usevolt/ccu/ce_mark_ccu.pdf

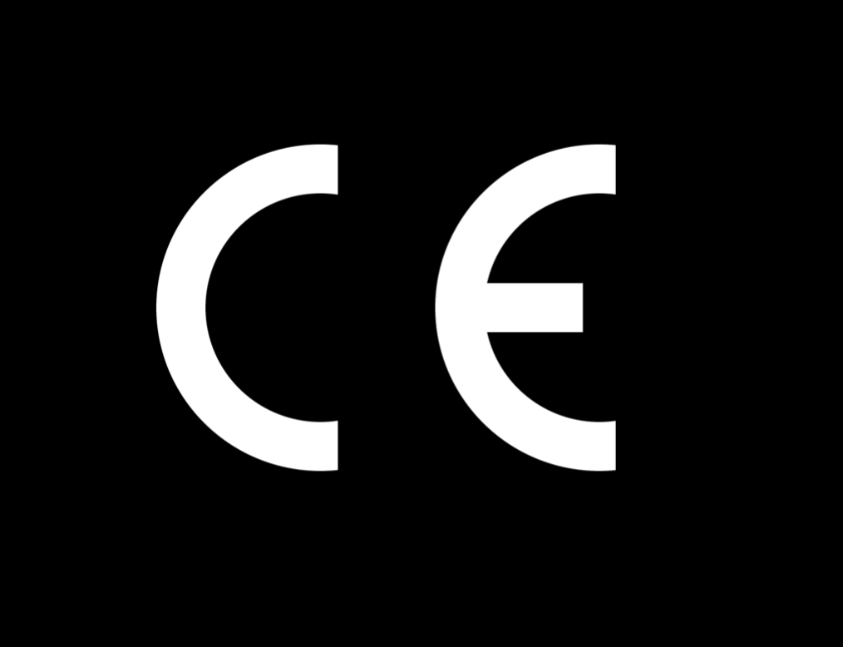
[picture p1: figure]

www.usewood.fi

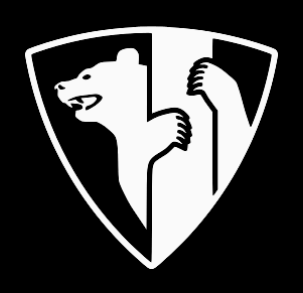
[picture p2: figure]

# Usewood CCU
