usevolt/ccu/ce_mark_ccu_55x20mm.png

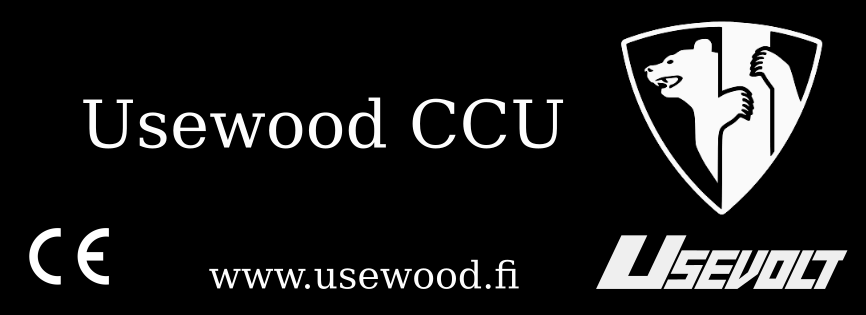
ce_mark_ccu_55x20mm.png
