usevolt/ccu/hw/ccu.FCStd

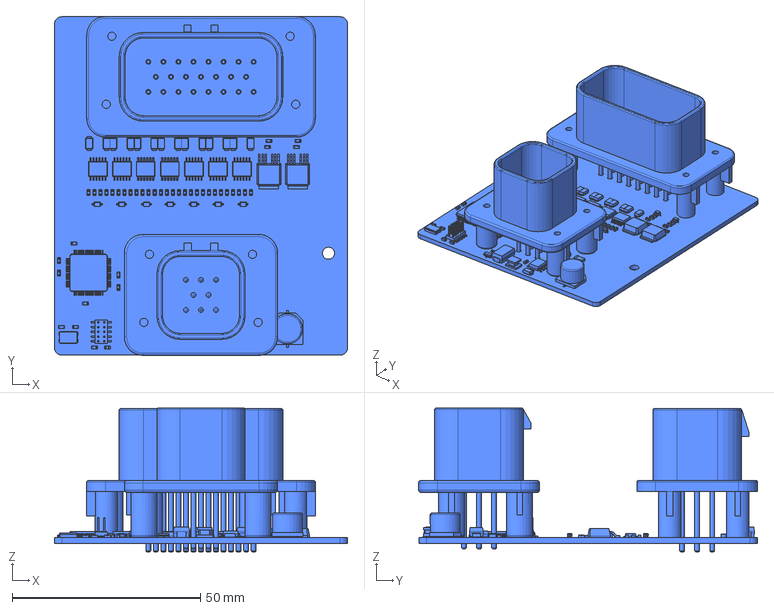
[picture p4: CAD file, 2018-11-13]
hw/ccu.FCStd
78.0 x 90.2 x 38.2 mm
