usevolt/ccu/hw/ccu_heatsink.step

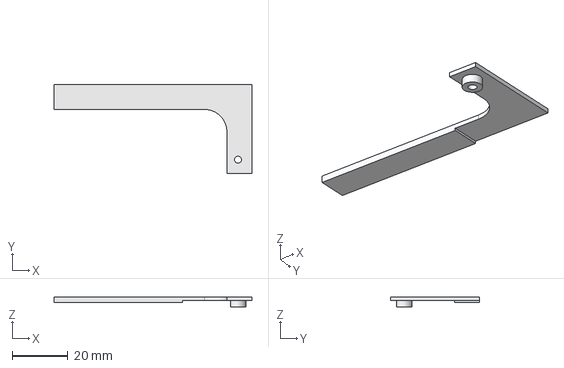
[picture p5: CAD file, 2018-11-07]
hw/ccu_heatsink.step
71.0 x 32.0 x 3.70 mm
