usevolt/ccu/hw/board_outline.dxf

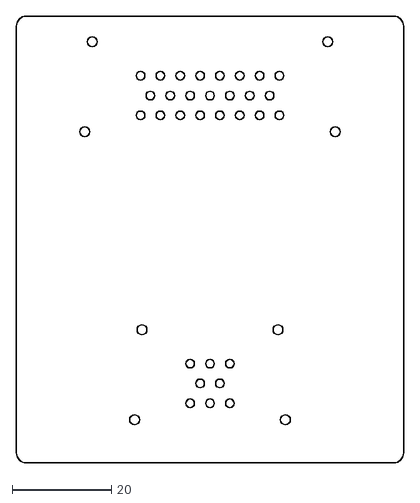
[picture p6: CAD file, 2018-07-01]
hw/board_outline.dxf
78.0 x 90.0
