usevolt/ccu/(list of files, cad)

Other CAD files:
hw/ccu_heatsink.fcstd
