usevolt/ccu/hw/ccu_heatsink.pdf

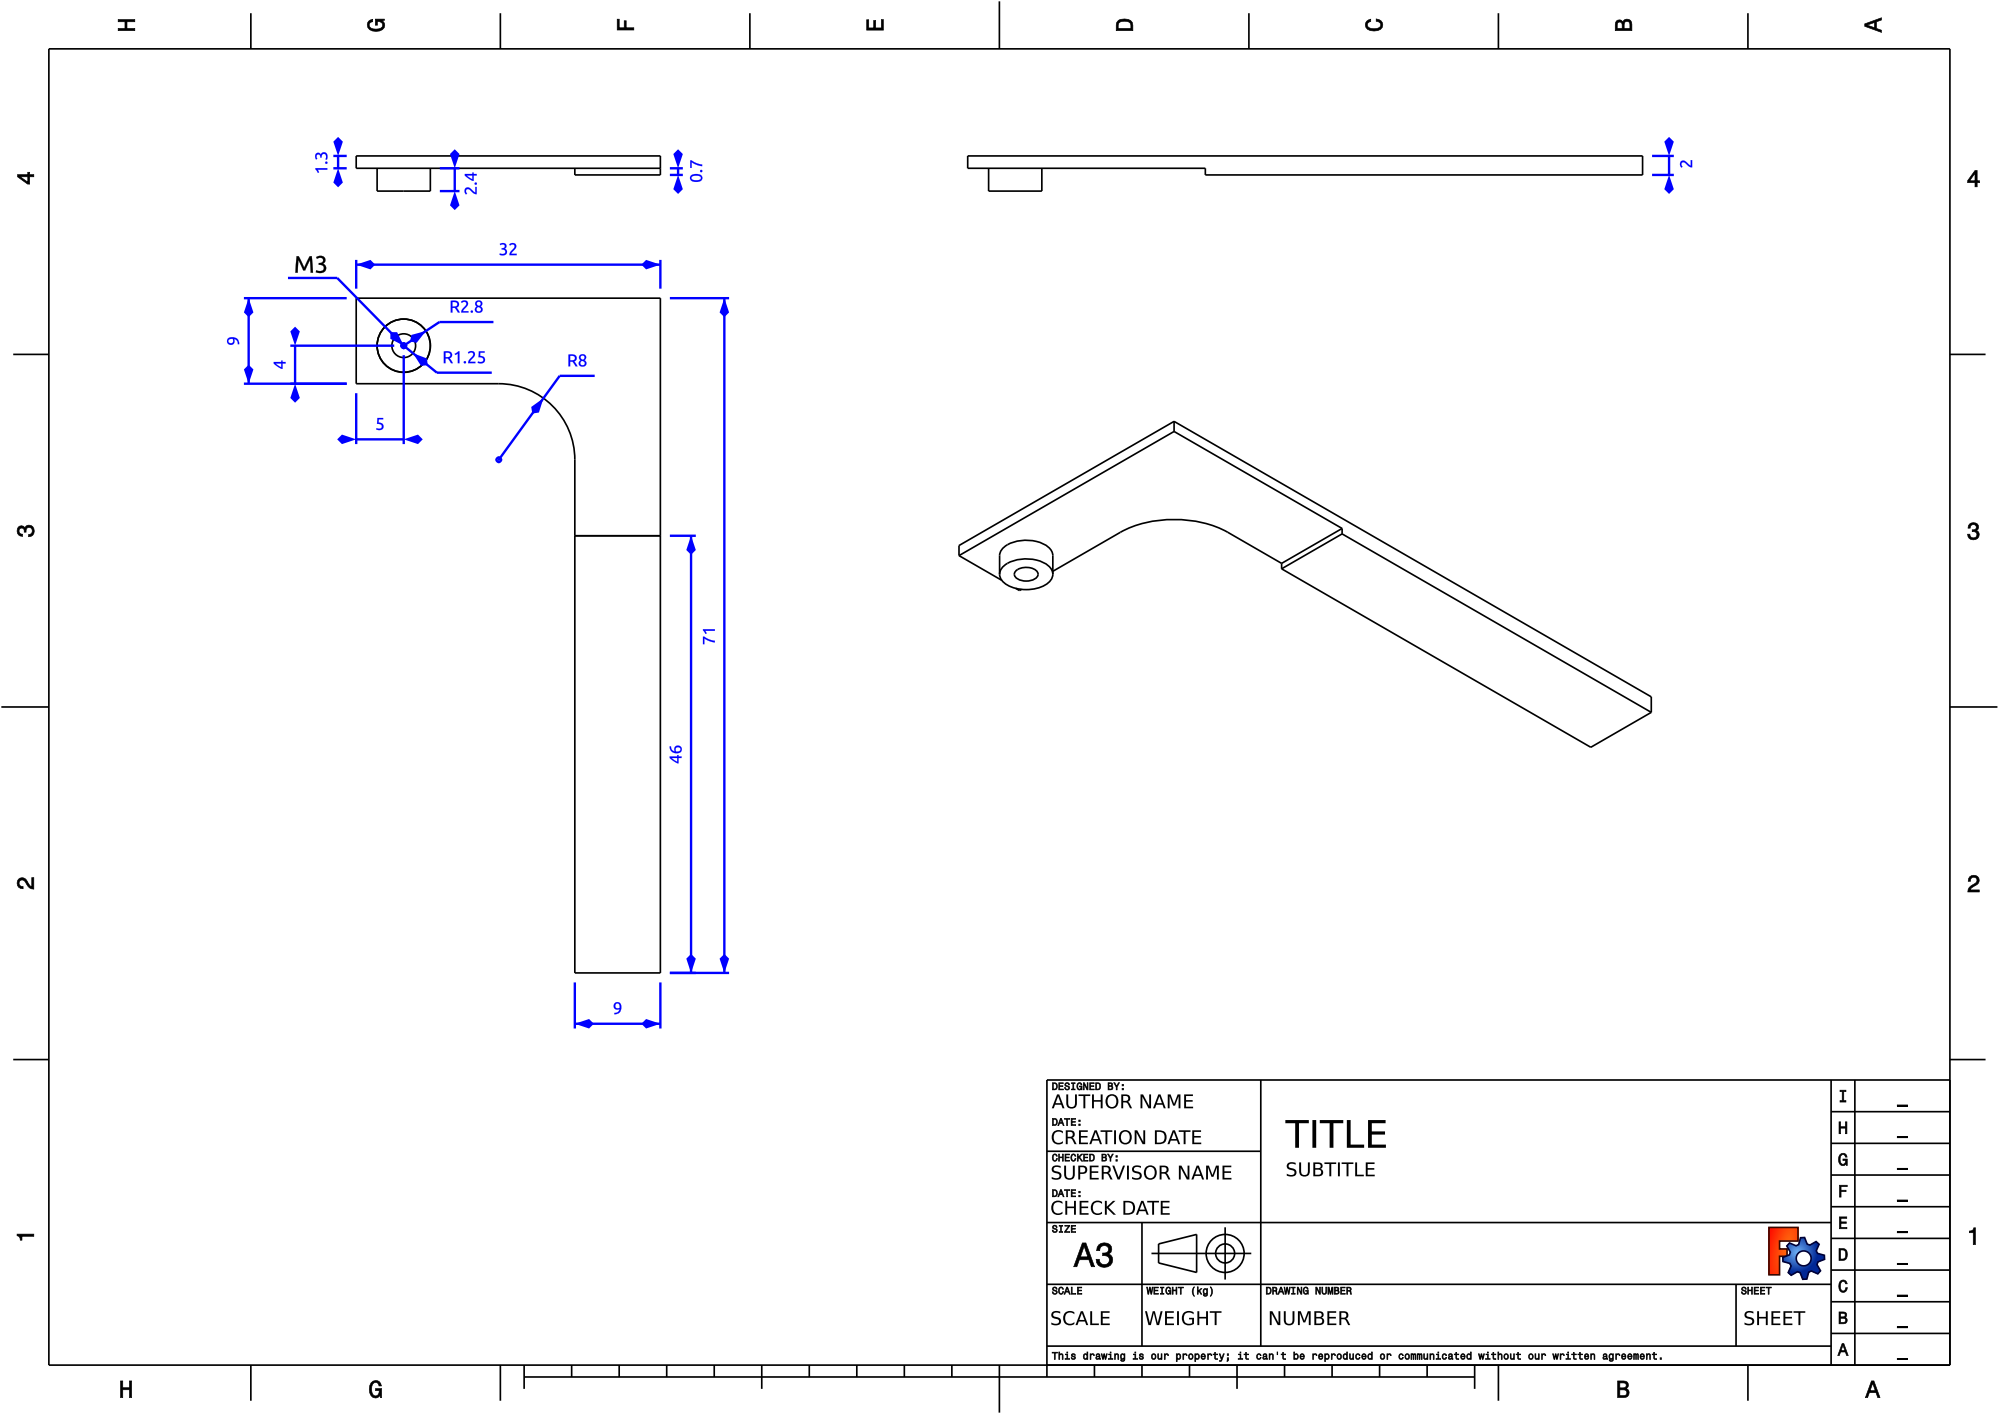
[picture p7: page 1]
