usevolt/ccu/sw/inc/pin_mappings.h

/*
 * pin_mappings.h
 *
 *  Created on: Jan 27, 2015
 *      Author: usenius
 *
 *  Defines keypad pin mappings for different pcb revisions used
 */

#ifndef UW_MB_SRC_PIN_MAPPINGS_H_
#define UW_MB_SRC_PIN_MAPPINGS_H_


#define PCB_1_5
//#define PCB_1_4

#if defined(PCB_1_5)
#define MCP2515_RESET		P0_17
#define SPI_CS_IO			P1_7
#define SPI_CLK_IO			P1_8
#elif defined(PCB_1_4)
#define MCP2515_RESET		P1_1
#define SPI_CS_IO			P0_9
#define SPI_CLK_IO			P0_10
#else
#error "Unknown PCB definition"
#endif


#define MCP2515_INT			P0_18


#define AIN1_IO				P0_9
#define AIN2_IO				P0_10

#define STEER_PWMA			PWM2_3
#define STEER_PWMB			PWM0_0
#define STEER_SENSE			ADC0_0

#define DRIVE1_PWMA			PWM1_4
#define DRIVE1_PWMB			PWM0_1
#define DRIVE1_SENSE		ADC0_3

#define DRIVE2_PWMA			PWM0_4
#define DRIVE2_PWMB			PWM1_3
#define DRIVE2_SENSE		ADC0_8

#define DRIVE3_PWMA			PWM0_3
#define DRIVE3_PWMB			PWM0_2
#define DRIVE3_SENSE		ADC0_11

#define CABROT_PWMA			PWM1_5
#define CABROT_PWMB			PWM1_0
#define CABROT_SENSE		ADC1_4

#define TELESCOPE_PWMA		PWM1_1
#define TELESCOPE_PWMB		PWM2_4
#define TELESCOPE_SENSE		ADC1_5

#define BRAKE_OUT			P0_26
#define BRAKE_SENSE			ADC1_8

#define CABBRAKE_OUT		P0_27
#define CABBRAKE_SENSE		ADC1_8

#define GEAR3_OUT			P0_24
#define GEAR3_SENSE			ADC1_9

#define BOOM_VDD_OUT		P1_5
#define BOOM_VDD_SENSE		ADC1_10

#endif /* UW_MB_SRC_PIN_MAPPINGS_H_ */
