usevolt/ccu/sw/src/modules/telescope.c

/* 
 * This file is part of the uv_hal distribution (www.usevolt.fi).
 * Copyright (c) 2017 Usevolt Oy.
 * 
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
 * You should have received a copy of the GNU General Public License 
 * along with this program. If not, see <http://www.gnu.org/licenses/>.
*/





#include "telescope.h"
#include "can_ccu.h"
#include "main.h"
#include "pin_mappings.h"
#include "drive.h"


void telescope_conf_reset(telescope_conf_st *this) {
	this->out_conf.acc = 70;
	this->out_conf.dec = 70;
	this->out_conf.invert = true;
	this->out_conf.assembly_invert = false;
	this->out_conf.solenoid_conf[DUAL_OUTPUT_SOLENOID_A].max_ma = 1200;
	this->out_conf.solenoid_conf[DUAL_OUTPUT_SOLENOID_A].min_ma = 500;
	this->out_conf.solenoid_conf[DUAL_OUTPUT_SOLENOID_B].max_ma = 1200;
	this->out_conf.solenoid_conf[DUAL_OUTPUT_SOLENOID_B].min_ma = 500;
}


void telescope_init(telescope_st *this, telescope_conf_st *conf_ptr) {
	input_init(&this->input);
	input_init(&this->bstr_input);
	this->conf = conf_ptr;

	uv_dual_solenoid_output_init(&this->out, &conf_ptr->out_conf, TELESCOPE_PWMA,
			TELESCOPE_PWMB, TELESCOPE_SENSE, dev.dither_freq, dev.dither_ampl,
			VND5050_CURRENT_AMPL_UA, SOLENOID_MAX_CURRENT, SOLENOID_FAULT_CURRENT,
			CCU_EMCY_TELESCOPE_OVERLOAD_A, CCU_EMCY_TELESCOPE_OVERLOAD_B,
			CCU_EMCY_TELESCOPE_FAULT_A, CCU_EMCY_TELESCOPE_FAULT_B);
}


void telescope_step(telescope_st *this, uint16_t step_ms) {
	if (dev.assembly.telescope_installed) {
		input_step(&this->input, step_ms);

		uv_dual_solenoid_output_set(&this->out,
					input_get_request(&this->input, &this->conf->out_conf));
	}
	else if (dev.assembly.backsteer_installed) {
		int16_t req = input_get_request(&this->bstr_input, &this->conf->out_conf);
		// back steering is disabled if the support legs are down
		if ((dev.hcu.left_foot_state == HCU_FOOT_DOWN) ||
				(dev.hcu.right_foot_state == HCU_FOOT_DOWN)) {
			req = 0;
		}
		if (cabrot_get_dir(&dev.cabrot) == CCU_CABDIR_BACKWARD) {
			req *= -1;
		}

		// steering enabled only when driving
		uv_dual_solenoid_output_set(&this->out,
				(input_get_request(&dev.drive.input, &this->conf->out_conf)) ? req : 0);
	}
	else {
		uv_dual_solenoid_output_set(&this->out, 0);
	}
}



void telescope_solenoid_step(telescope_st *this, uint16_t step_ms) {
	if (dev.assembly.telescope_installed || dev.assembly.backsteer_installed) {
		uv_dual_solenoid_output_step(&this->out, step_ms);
	}
}
