usevolt/ccu/(commit log)

2018-05-29 1.0 ordered
    [MCP2515.sch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]
2018-07-01 8 pin ampseal changed to white one
    [board_outline.dxf, ccu.FCStd, ccu.kicad_pcb, ccu.sch, vn5e010ah.sch, vnd5050.sch]
2018-08-12 pull down resistor to boom vdd added, flyback diodes replaced with zeners
    [ccu.kicad_pcb, vn5e010ah.sch, vnd5050.sch]
2018-09-18 cabrot and telescope can be disabled via eeprom assembly parameters
2018-10-04 1.1.0 pcb with zener protection diodes
    [ccu-B.Cu.gbl, ccu-B.Mask.gbs, ccu-B.SilkS.gbo, ccu-Edge.Cuts.gm1, ccu-F.Cu.gtl, ccu-F.Paste.gtp, ccu-F.SilkS.gto, ccu-NPTH.drl]
2018-11-05 assembly setting order corrected
    [drive.c, main.h]
2018-11-07 heatsink created
    [ccu.FCStd, ccu.kicad_pcb, ccu_heatsink.fcstd, ccu_heatsink.step]
2018-11-13 tantalum cap added to mcp2515
    [MCP2515.sch, ccu.FCStd, ccu.kicad_pcb, ccu_heatsink.fcstd, vnd5050.sch]
2018-11-27 1st gear back wheeks drive direction inverted (for CM_6.1.2
    [drive.c]
2018-12-04 default gear set to 1
2018-12-07 if mcp2515 init fails, enabled terminal and logs an error message
    [main.c]
2018-12-21 pcb 1.2.0 created, with attachment hole
    [ccu-B.Cu.gbl, ccu-B.Mask.gbs, ccu-B.SilkS.gbo, ccu-Edge.Cuts.gm1, ccu-F.Cu.gtl, ccu-F.Mask.gts, ccu-F.Paste.gtp, ccu-F.SilkS.gto]
2018-12-21 pcb 1.3.0: pcb version label updated
    [ccu.kicad_pcb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]
2019-01-24 step task priority increased over solenoid task
2019-02-10 wdt implemented to prevent freezing with movements
    [ccu.drl]
2019-02-10 1.4.0 pcb created, tantalum caps changed to bigger ones
    [MCP2515.sch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]
2019-02-19 movement freezing fixed with wdt and dual solenoid dec adjusted
    [main.c]
2019-03-19 gear count in assembly settings
2019-05-04 gear count min value is 1
2019-05-10 GEAR3 max current increased to 8 A
2019-06-03 back steering bug fixes
    [telescope.c]
2019-07-24 hw 1.5.0, 2 ain inputs added
    [MCP2515.sch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]
2019-08-15 Bugfix: UW LM back steering doesnt trigger 4wd off on first gear
    [drive.c]
2019-08-23 bugfix fetched from hcu: mcu freezes while adc is making a conversion and interrupts might happen
2019-08-23 steer and back steer disabled if the support legs are down
2019-09-19 gear3 assembly invert controls gear2 and 3 order
    [drive.c]
2019-10-10 pin mappings remapped to hw 1.5.0
2019-11-22 gear changed to right hand
2020-01-12 drive: bugfix with gear3 valve, when assembly invert is true
    Fixed bug where gear3 was active on 1st gear is assembly_invert was true
    [drive.c, telescope.c]
2020-01-17 drive gear3 dec default set to 25
2020-05-14 pin mappings can b configured also for 1.4 pcb
2020-05-14 pin mappings defaults to pcb 1.5
2020-07-17 seat & door switches softly stop driving
2020-08-04 bugfix: drive req is always zero when the legs are down
    [main.c]
2020-08-20 bugfix: cabdir eeprom address correctred
    [main.h, messages.c]
2020-10-28 cabrot pressure limit implemented
2020-12-28 forwarder valve wirings renamed and modified. steer valves are as subindexes to right hand wires
2020-12-29 cabrot max pressure set to 80 bar
2021-01-04 cabrot max pressure 110 bar
